laureanobruno/ObservAR/README.md

# ObservAR

## ESP32

Aquí se encuentra tanto la librería con el modelo de detencción del objeto cómo el código para enviar los datos correspondientes por UART.

## FirmwareV

En este directorio se encuentran las librerías de la CIAA y el código principal que recibe los datos, mueve el servo y detecta cuando alguno de los botones es presionado.
