laureanobruno/ObservAR/(commit log)

2024-02-06 Primer commit
    [CIAA-Z3R0 bom_v0.2.xls, lpc4337.cfg, lpc4337_new.cfg, lpc4337_old.cfg]
2024-02-06 Saco cosas de más
